vlad-brasoveanu/STM32-Robotic-Arm-6DoF/Core/Inc/main.h

#define B1_Pin GPIO_PIN_13
#define B1_GPIO_Port GPIOC
#define SELECT_BTN_Pin GPIO_PIN_0
#define SELECT_BTN_GPIO_Port GPIOC
#define PLUS_BTN_Pin GPIO_PIN_1
#define PLUS_BTN_GPIO_Port GPIOC
#define MINUS_BTN_Pin GPIO_PIN_2
#define MINUS_BTN_GPIO_Port GPIOC
#define MODE_BTN_Pin GPIO_PIN_3
#define MODE_BTN_GPIO_Port GPIOC
#define RECORD_BTN_Pin GPIO_PIN_1
#define RECORD_BTN_GPIO_Port GPIOA
#define USART_TX_Pin GPIO_PIN_2
#define USART_TX_GPIO_Port GPIOA
#define USART_RX_Pin GPIO_PIN_3
#define USART_RX_GPIO_Port GPIOA
#define PLAY_BTN_Pin GPIO_PIN_4
#define PLAY_BTN_GPIO_Port GPIOA
#define LD2_Pin GPIO_PIN_5
#define LD2_GPIO_Port GPIOA
#define E_STOP_BTN_Pin GPIO_PIN_0
#define E_STOP_BTN_GPIO_Port GPIOB
#define RELAY_CTRL_Pin GPIO_PIN_12
#define RELAY_CTRL_GPIO_Port GPIOB
#define TMS_Pin GPIO_PIN_13
#define TMS_GPIO_Port GPIOA
#define TCK_Pin GPIO_PIN_14
#define TCK_GPIO_Port GPIOA
#define SWO_Pin GPIO_PIN_3
#define SWO_GPIO_Port GPIOB
#define HOME_BTN_Pin GPIO_PIN_7
#define HOME_BTN_GPIO_Port GPIOB
