vlad-brasoveanu/STM32-Robotic-Arm-6DoF/Core/Inc/lcd_i2c.h

#ifndef LCD_I2C_H
#define LCD_I2C_H

#include "stm32f4xx_hal.h"

// Functii publice
void LCD_Init(void);
void LCD_Print(char *str);
void LCD_SetCursor(uint8_t row, uint8_t col);
void LCD_Clear(void);

#endif
